Eason070211/Thermocouple/PCB/BOM_Board1_Schematic1_2026-10-04.xlsx

Sheet: bom模板
 |  |  |  | Bill of Materials | BOM_Board1_Schematic1_2026-10-04
 |  |  |  | Project Title： | Thermocouple
 |  |  |  | Variant:
 |  |  |  | Report Time： | 2026年10月4日 10:58:56
No. | Quantity | Comment | Designator | Footprint | Value | Manufacturer Part | Manufacturer | Supplier Part | Supplier | LCSC Price | Total
 | 22 | 1uF | C7, C8, C9, C10, C11, C12, C13, C14, C16, C17, C69, C70, C72, C73, C75, C76, C80, C81, C82, C83, C87, C88 | C0603 | 1uF | CL10A105KB8NNNC | SAMSUNG(三星) | C15849 | LCSC
 | 2 | 10uF | C1, C2 | C0603 | 10uF | CGA0603X5R106K100JT | HRE(芯声) | C6119842 | LCSC
 | 2 | 22pF | C93, C94 | C0603 | 22pF | CL10C220JB8NNNC | SAMSUNG(三星) | C1653 | LCSC
 | 2 | 22uF | C4, C5 | C0603 | 22uF
 | 6 | 100nF | C95, C96, C97, C98, C99, C100 | C0603 | 100nF | CC0603KRX7R9BB104 | YAGEO(国巨) | C14663 | LCSC
 | 13 | 100nF | C3, C6, C15, C18, C20, C21, C71, C74, C77, C85, C86, C89, C90 | C0603 | 100nF | FCC0603B104K500CT | FOJAN(富捷) | C5137636 | LCSC
 | 1 | 105 | C101 | C0603
 | 1 | 106 | C102 | C0603
 | 8 | KF128-5.08-2P-AA | H1, H2, H3, H4, H5, H6, H7, H8 | CONN-TH_P5.08_KF128-5.08-2P |  | KF128-5.08-2P-AA | KEFA(科发) | C474952 | LCSC
 | 1 | DC-005-A200 | DC2 | DC-IN-TH_DC-005-A200 |  | DC-005-A200 | XUNPU(讯普) | C720557 | LCSC
 | 1 | 220S-1*4P H=8.5MM Ytype Gold-plated | Burn | DIP-1X4P2.54 |  | 220S-1*4P H=8.5MM Ytype Gold-plated | Ckmtw | C124413 | LCSC
 | 1 | COM | COM | DIP-1X4P2.54 |  | 220S-1*4P H=8.5MM Ytype Gold-plated | Ckmtw | C124413 | LCSC
 | 1 | 8MHz | X2 | HC-49US_L11.5-W4.5-P4.88 | 8MHz | 9B08000006 | TXC(台湾晶技) | C97198 | LCSC
 | 1 | 2.2uH | L1 | IND-SMD_FCD32-2R2M | 2.2uH | FCD32-2R2M | cjiang(长江微电) | C41382324 | LCSC
 | 1 | Switch3x4x2 | KEY2 | KEY-3.0*4.0 |  | Switch3x4x2 | ReliaPro | C26638 | LCSC
 | 5 | CBW321609U601T | L2, L3, L9, L10, L11 | L1206 |  | CBW321609U601T | FH(风华) | C73732 | LCSC
 | 3 | LED_0603-R | LED1, LED2, LED3 | LED_0603
 | 1 | STM32F103C8T6 | U13 | LQFP-48_L7.0-W7.0-P0.50-LS9.0-BL |  | STM32F103C8T6 | STMicroelectronics | C8734 | LCSC
 | 9 | 10kΩ | R1, R2, R18, R19, R20, R38, R39, R40, R41 | R0603 | 10kΩ | 0603WAF1002T5E | UNI-ROYAL(厚声) | C25804 | LCSC
 | 1 | 10kΩ | R56 | R0603 | 10kΩ | FRC0603J103 TS | FOJAN(富捷) | C2930027 | LCSC
 | 1 | 36kΩ | R3 | R0603 | 36kΩ | FRC0603F3602TS | FOJAN(富捷) | C2930097 | LCSC
 | 1 | 100kΩ | R57 | R0603 | 100kΩ | FRC0603F1003TS | FOJAN(富捷) | C2906980 | LCSC
 | 1 | CH340N | CH1 | SOP-8_L4.9-W3.9-P1.27-LS6.0-BL |  | CH340N | WCH(南京沁恒) | C2977777 | LCSC
 | 2 | TPS7A2033PDBVR | U6, U7 | SOT-23-5_L2.9-W1.6-P0.95-LS2.8-BR |  | TPS7A2033PDBVR | TI(德州仪器) | C2862740 | LCSC
 | 1 | TPS563201DDCR | U5 | SOT-23-6_L2.9-W1.6-P0.95-LS2.8-BR |  | TPS563201DDCR | TI(德州仪器) | C116592 | LCSC
 | 1 | AMS1117-3.3V | Q3 | SOT-89-3_L4.5-W2.5-P1.50-LS4.2-BR |  | AMS1117-3.3V | MSKSEMI(美森科) | C5120796 | LCSC
 | 4 | ADS1220IPWR | U1, U2, U3, U4 | TSSOP-16_L5.0-W4.4-P0.65-LS6.4-BL |  | ADS1220IPWR | TI(德州仪器) | C48263 | LCSC
 | 1 | Type-C 16P | P1 | TYPE-C 16P

Sheet: Field汇总
Project Title | Thermocouple
Borard Title | Board1
Schematic Title | Schematic1
PCB Title | Final
Variant Name
Total Quantity | 94
Report Time | 10:58:56
Report Date | 2026年10月4日
Report Date&Time | 2026年10月4日 10:58:56
File Name | BOM_Board1_Schematic1_2026-10-04
Filter Option | Add into BOM:no;
