Eason070211/Thermocouple/Core/Src/usart.c

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
/* Includes ------------------------------------------------------------------*/
#include "usart.h"
#include "board_config.h"

UART_HandleTypeDef huart1;

/* USART1 init function */

void MX_USART1_UART_Init(void)
{

  /* USER CODE BEGIN USART1_Init 1 */
  /* 波特率由 board_config.h 的 UART_BAUDRATE 决定, 默认 115200, 可改 460800。
   * SystemClock_Config() 里 APB2 = HCLK = 72MHz, 所以:
   *   115200 : 72e6 / 115200  = 625.0000  -> 整数分频, 0% 误差
   *   460800 : 72e6 / 460800  = 156.2500  -> BRR 小数部分正好 4/16, 0% 误差
   * 高速采样率 (DR > 90SPS) 时一帧温度 133 字节在 115200 下要 11.5ms,
   * 会明显拖慢上报, 这时应该切到 460800 (2.9ms)。详见 docs/TIMING.md。 */
  /* USER CODE END USART1_Init 1 */
  huart1.Instance = USART1;
  huart1.Init.BaudRate = UART_BAUDRATE;
  huart1.Init.WordLength = UART_WORDLENGTH_8B;
  huart1.Init.StopBits = UART_STOPBITS_1;
  huart1.Init.Parity = UART_PARITY_NONE;
  huart1.Init.Mode = UART_MODE_TX_RX;
  huart1.Init.HwFlowCtl = UART_HWCONTROL_NONE;
  huart1.Init.OverSampling = UART_OVERSAMPLING_16;
  if (HAL_UART_Init(&huart1) != HAL_OK)
  {
    Error_Handler();
  }
}

void HAL_UART_MspInit(UART_HandleTypeDef* uartHandle)
{

  GPIO_InitTypeDef GPIO_InitStruct = {0};
  if(uartHandle->Instance==USART1)
  {
    /* USART1 clock enable */
    __HAL_RCC_USART1_CLK_ENABLE();

    __HAL_RCC_GPIOA_CLK_ENABLE();
    /**USART1 GPIO Configuration
    PA9     ------> USART1_TX
    PA10     ------> USART1_RX
    */
    GPIO_InitStruct.Pin = UART1_TX_PIN;
    GPIO_InitStruct.Mode = GPIO_MODE_AF_PP;
    GPIO_InitStruct.Speed = GPIO_SPEED_FREQ_HIGH;
    HAL_GPIO_Init(UART1_GPIO_PORT, &GPIO_InitStruct);

    GPIO_InitStruct.Pin = UART1_RX_PIN;
    GPIO_InitStruct.Mode = GPIO_MODE_INPUT;
    GPIO_InitStruct.Pull = GPIO_PULLUP;      /* 上位机没接时避免悬空噪声触发假起始位 */
    HAL_GPIO_Init(UART1_GPIO_PORT, &GPIO_InitStruct);

    /* USART1 interrupt Init: 逐字节接收中断, 中断里只喂协议状态机 */
    HAL_NVIC_SetPriority(USART1_IRQn, UART1_IRQ_PRIO, 0);
    HAL_NVIC_EnableIRQ(USART1_IRQn);

  }
}

void HAL_UART_MspDeInit(UART_HandleTypeDef* uartHandle)
{

  if(uartHandle->Instance==USART1)
  {
    /* Peripheral clock disable */
    __HAL_RCC_USART1_CLK_DISABLE();

    /**USART1 GPIO Configuration
    PA9     ------> USART1_TX
    PA10     ------> USART1_RX
    */
    HAL_GPIO_DeInit(UART1_GPIO_PORT, UART1_TX_PIN|UART1_RX_PIN);

    /* USART1 interrupt Deinit */
    HAL_NVIC_DisableIRQ(USART1_IRQn);

  }
}
