Eason070211/Thermocouple/(commit log)

2026-10-04 4 chips 8 channel with PCB
2026-10-04 update ui
    [BOM_Board1_Schematic1_2026-10-04.xlsx, tc_type_e.csv, tc_type_j.csv, tc_type_k.csv, tc_type_n.csv, tc_type_t.csv]
2026-10-04 fixed minor bugs
    [tc_type_e.csv, tc_type_j.csv, tc_type_k.csv, tc_type_n.csv, tc_type_t.csv, temperature_20261004_213740.csv]
